pepassaco/CloCh/plots/preliminary_results_exp1.pdf

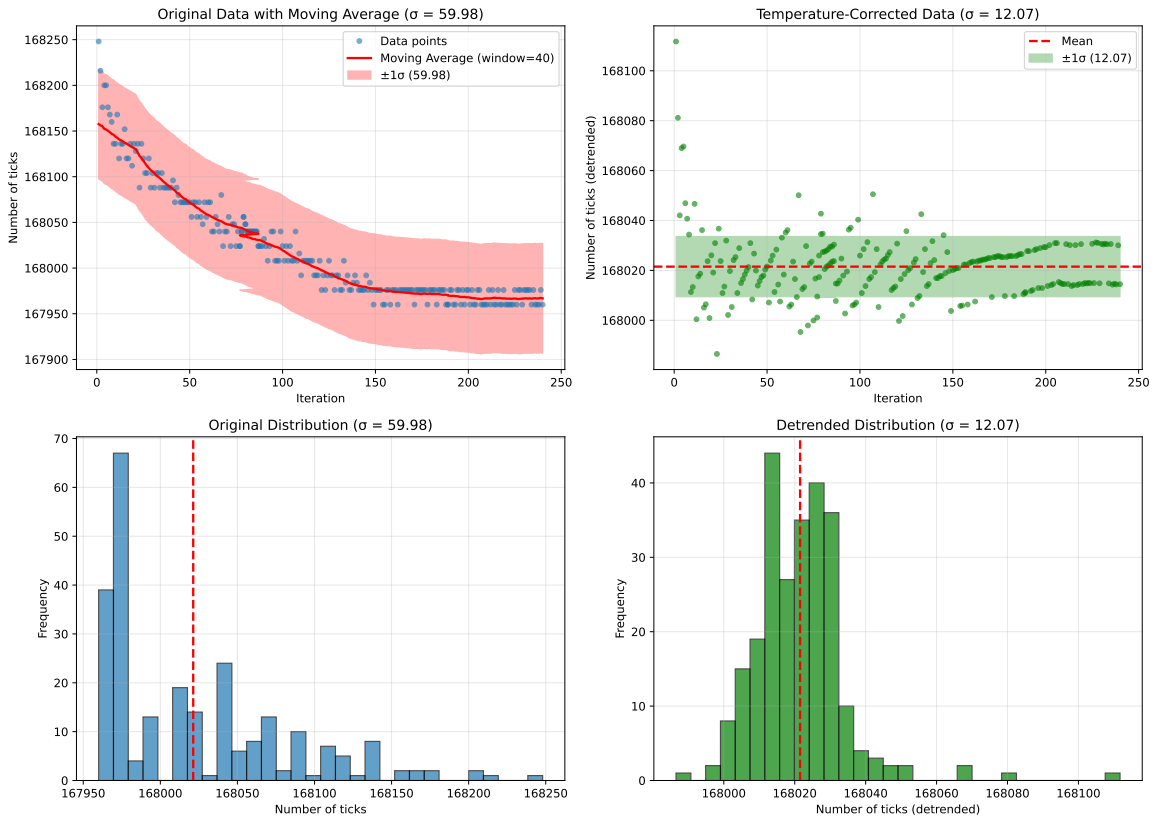
[picture p1: page 1]
Iteration; Mean; Frequency; Original Distribution ( = 59.98); Detrended Distribution ( = 12.07)

Original Data with Moving Average ( = 59.98)

Temperature-Corrected Data ( = 12.07)

Data points
Moving Average (window=40)

Number of ticks (detrended)

Number of ticks
