pepassaco/CloCh/plots/preliminary_results_exp2.pdf

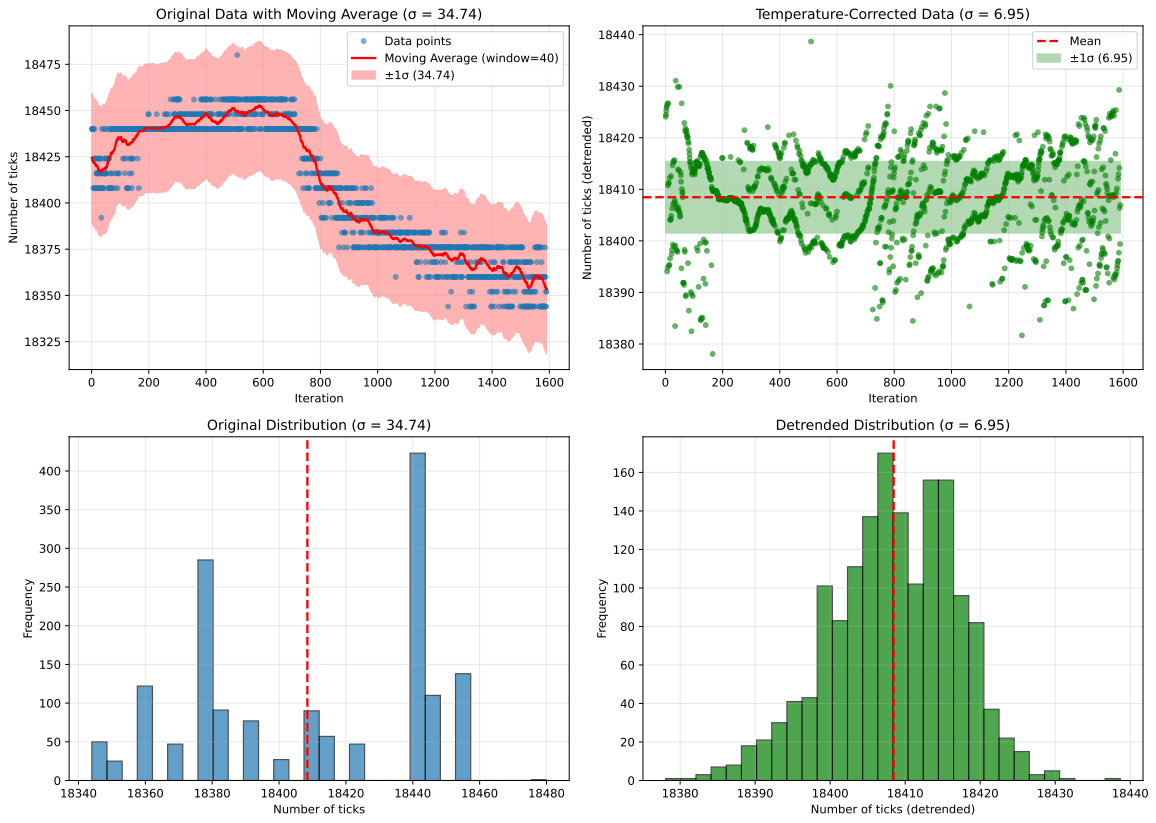
[picture p2: page 1]
Iteration; Mean; Frequency; Original Distribution ( = 34.74); Detrended Distribution ( = 6.95)

Original Data with Moving Average ( = 34.74)

Temperature-Corrected Data ( = 6.95)

Data points Moving Average (window=40)

Number of ticks (detrended)

Number of ticks
