pepassaco/CloCh/hardware/schematics/CloCh_v1.3_sch.pdf

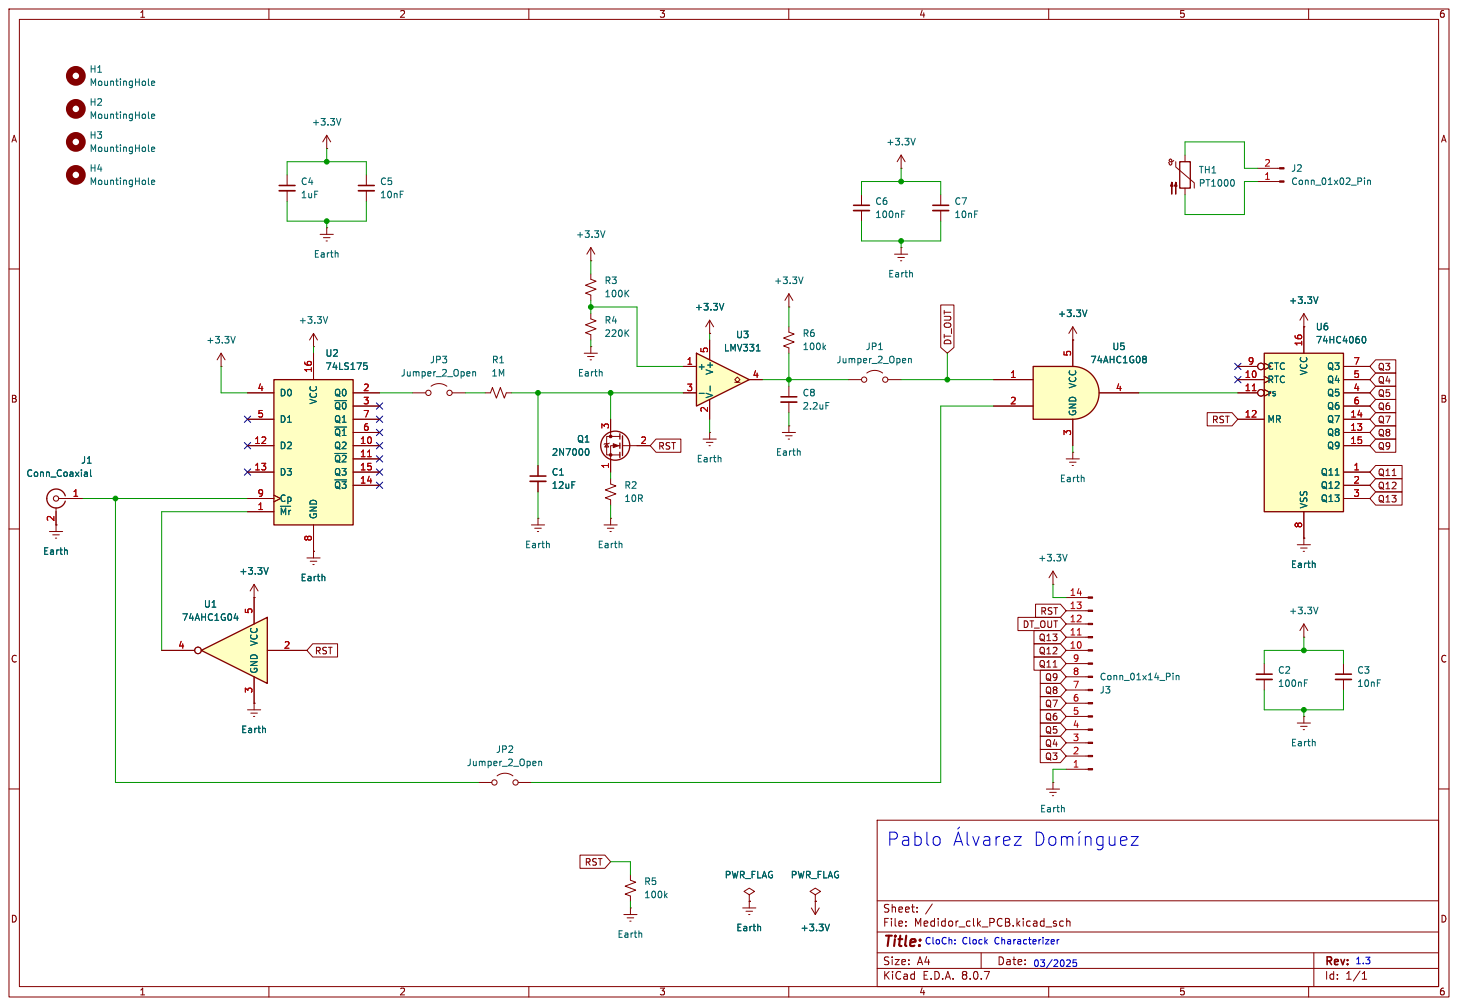
[picture p3: page 1]

Id: 1/1 Title: File: Medidor_clk_PCB.kicad_sch Sheet: / JP2

1.3 03/2025 CloCh: Clock Characterizer Pablo þÿÁlvarez þÿDomínguez
