pepassaco/CloCh/plots/paper_results_exp2.pdf

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

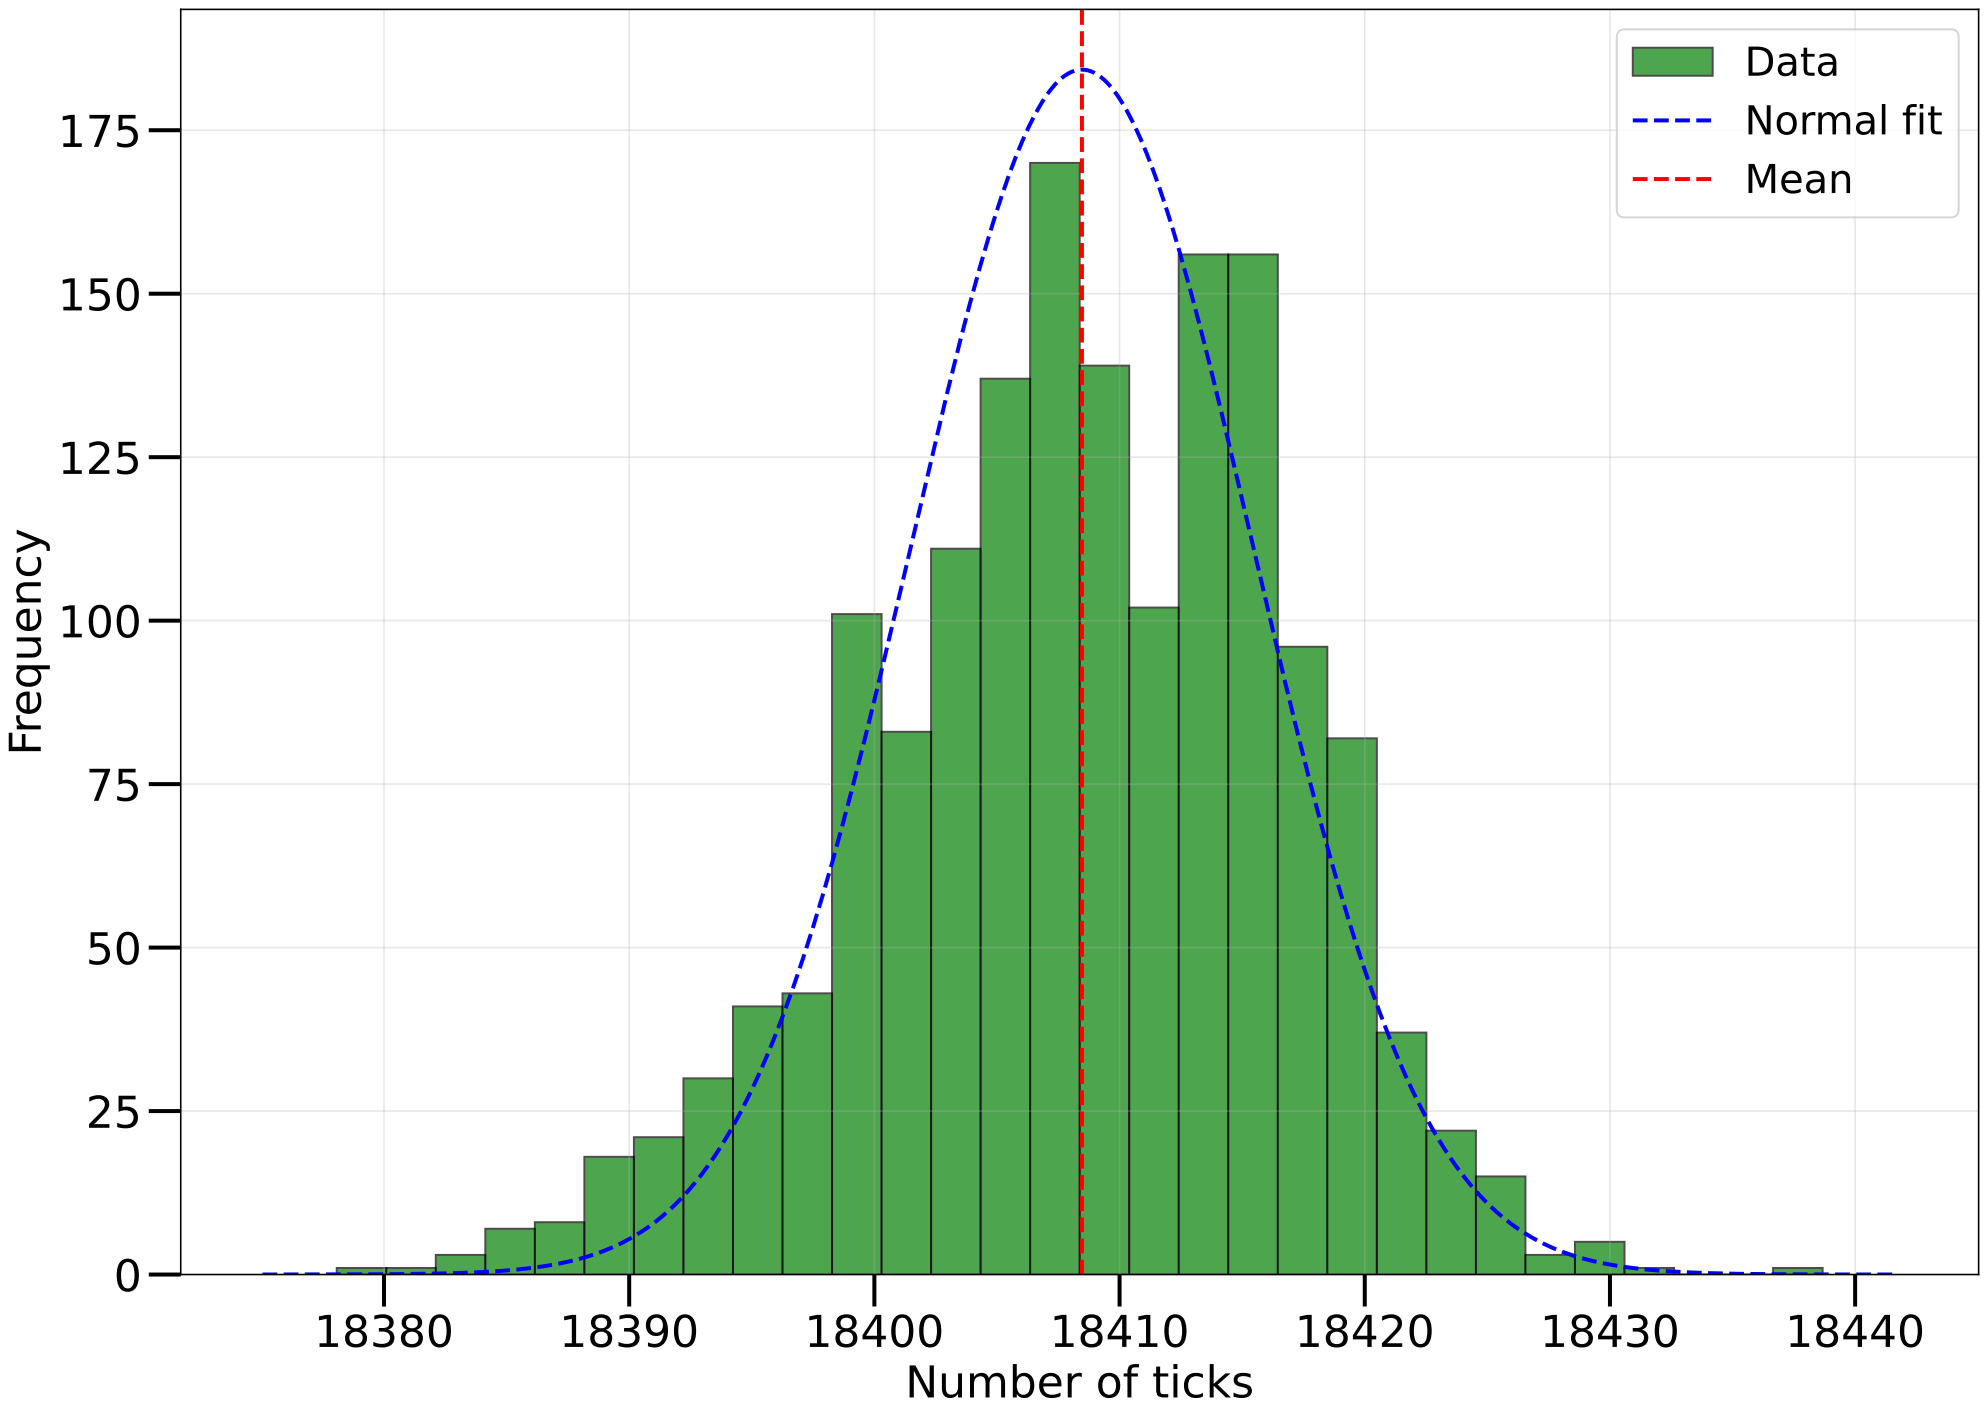
[picture p5: page 1]
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
