pepassaco/CloCh/hardware/schematics/CloCh_v1.3_pcb.pdf

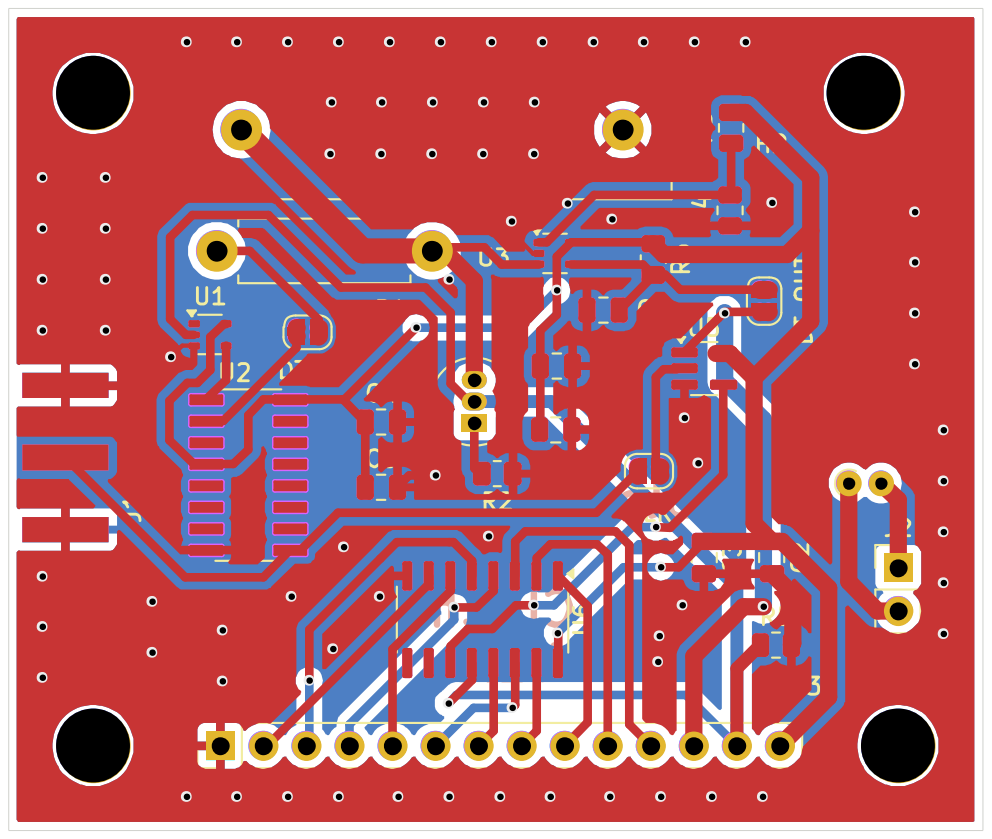
[picture p6: page 1]
