pepassaco/CloCh/hardware/PCB/kicad/CloCh_v1.3.kicad_pcb

## KiCad design hardware/PCB/kicad/CloCh_v1.3.kicad_pcb (2025-10-25)

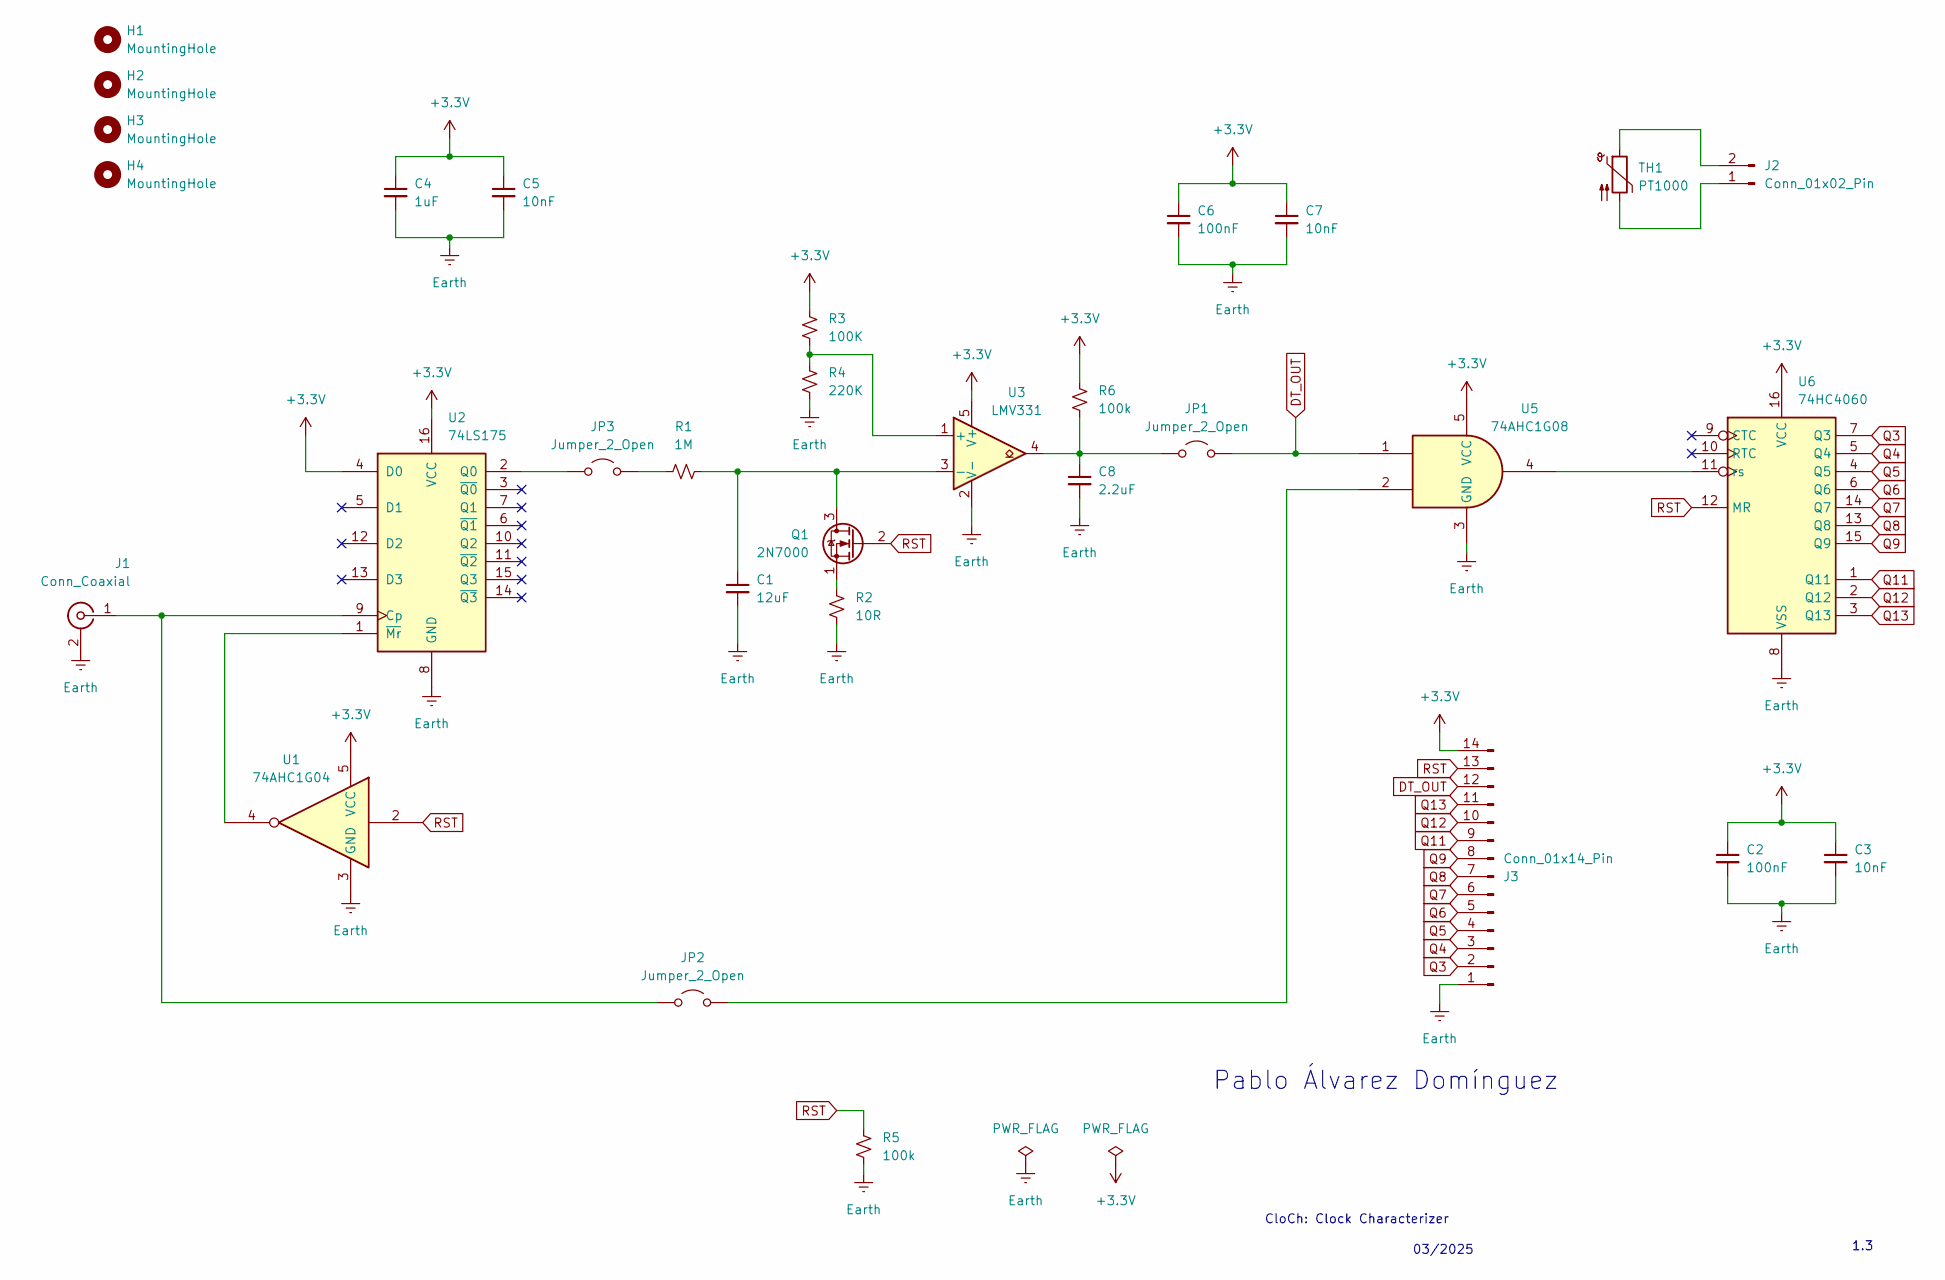
[picture p7: schematic CloCh_v1.3.kicad_sch]

Parts:
C1: 12uF; C_Rect_L28.0mm_W8.0mm_P22.50mm_MKS4
C2, C6: 100nF; C_0805_2012Metric
C3, C5, C7: 10nF; C_0805_2012Metric
C4: 1uF; C_0805_2012Metric
C8: 2.2uF; C_0805_2012Metric
H1, H2, H3, H4: MountingHole; MountingHole_4.3mm_M4_ISO7380
J1: Conn_Coaxial; SMA_Amphenol_132289_EdgeMount
J2: Conn_01x02_Pin; PinHeader_1x02_P2.54mm_Vertical
J3: Conn_01x14_Pin; PinHeader_1x14_P2.54mm_Vertical
JP1, JP2, JP3: Jumper_2_Open; SolderJumper-2_P1.3mm_Open_RoundedPad1.0x1.5mm
Q1: 2N7000; TO-92_Inline
R1: 1M; R_Axial_DIN0411_L9.9mm_D3.6mm_P12.70mm_Horizontal
R2: 10R; R_0805_2012Metric
R3: 100K; R_0805_2012Metric
R4: 220K; R_0805_2012Metric
R5, R6: 100k; R_0805_2012Metric
TH1: PT1000; R_Axial_DIN0204_L3.6mm_D1.6mm_P1.90mm_Vertical
U1: 74AHC1G04; SOT-353_SC-70-5
U2: 74LS175; SOIC127P600X175-16N
U3: LMV331; SOT-353_SC-70-5
U5: 74AHC1G08; SC-74A-5_1.55x2.9mm_P0.95mm
U6: 74HC4060; SO-16_3.9x9.9mm_P1.27mm

Connections:
+3.3V: C2.1, C3.1, C4.1, C5.1, C6.1, C7.1, J3.14, R3.2, R6.1, U1.5 (VCC), U2.4 (D0), U2.16 (VCC), U3.5 (V+), U5.5 (VCC), U6.16 (VCC)
DT_OUT: J3.12, JP1.2 (B), U5.1
Earth: C1.2, C2.2, C3.2, C4.2, C5.2, C6.2, C7.2, C8.2, J1.2 (Ext), J3.1, R2.1, R4.1, R5.2, U1.3 (GND), U2.8 (GND), U3.2 (V-), U5.3 (GND), U6.8 (VSS)
unnamed: J1.1 (In), JP2.1 (A), U2.9 (Cp)
unnamed: J2.1, TH1.2
unnamed: J2.2, TH1.1
unnamed: C8.1, JP1.1 (A), R6.2, U3.4
unnamed: JP2.2 (B), U5.2
unnamed: JP3.1 (A), U2.2 (Q0)
unnamed: JP3.2 (B), R1.1
unnamed: C1.1, Q1.3 (D), R1.2, U3.3 (-)
unnamed: Q1.1 (S), R2.2
unnamed: U1.4, U2.1 (~Mr)
unnamed: R3.1, R4.2, U3.1 (+)
unnamed: U5.4, U6.11 (rs)
Q3: J3.2, U6.7 (Q3)
Q4: J3.3, U6.5 (Q4)
Q5: J3.4, U6.4 (Q5)
Q6: J3.5, U6.6 (Q6)
Q7: J3.6, U6.14 (Q7)
Q8: J3.7, U6.13 (Q8)
Q9: J3.8, U6.15 (Q9)
Q11: J3.9, U6.1 (Q11)
Q12: J3.10, U6.2 (Q12)
Q13: J3.11, U6.3 (Q13)
RST: J3.13, Q1.2 (G), R5.1, U1.2, U6.12 (MR)

Notes on the sheet:
03/2025
CloCh: Clock Characterizer
1.3
Pablo Álvarez Domínguez

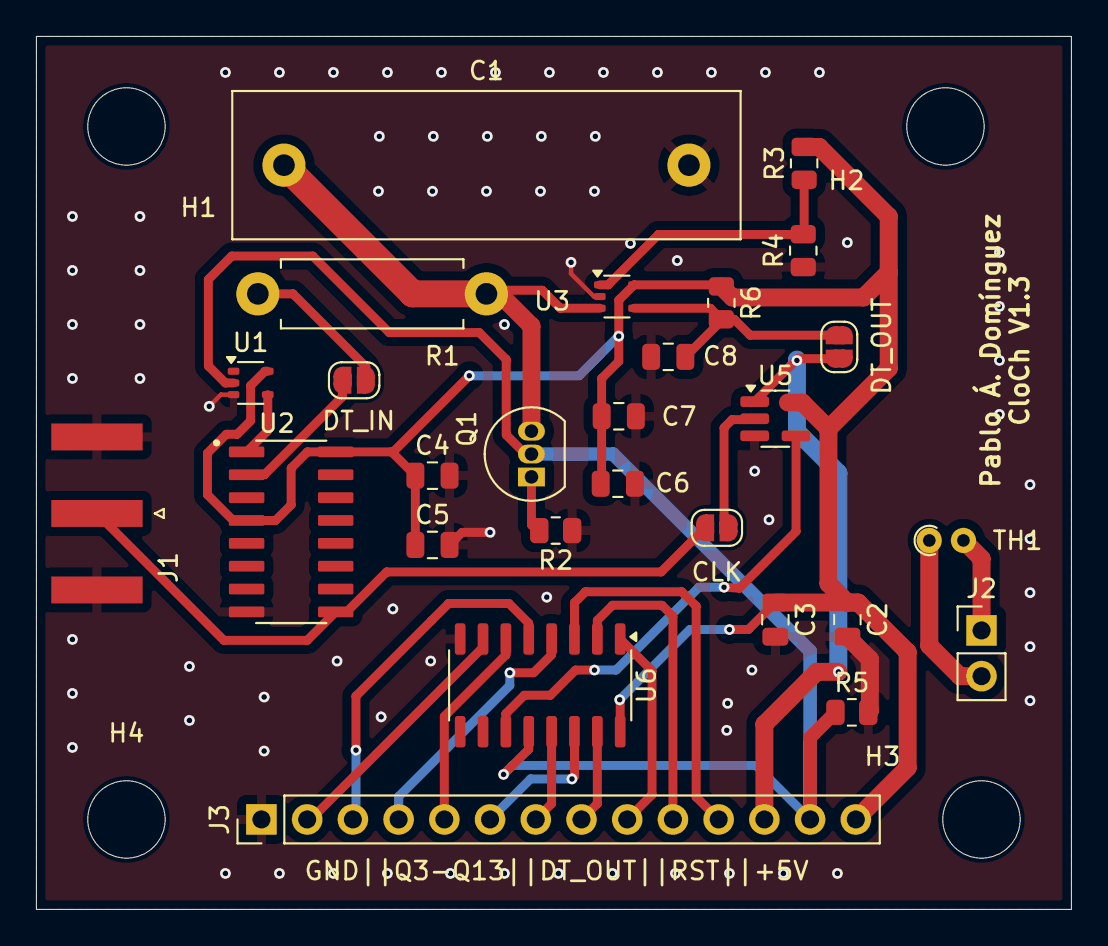
[picture p8: board CloCh_v1.3.kicad_pcb from above]

Board: 2 copper layers, 57.5 x 48.5 mm, 31 parts (0 on the bottom side), 26 nets.
