pepassaco/CloCh/(commit log)

2025-10-24 Initial commit with firmware and data
    [exp1.csv]
2025-10-24 Added PCB documentation
    [CloCh_v1.3-CuBottom.gbr, CloCh_v1.3-CuTop.gbr, CloCh_v1.3-EdgeCuts.gbr, CloCh_v1.3-MaskBottom.gbr, CloCh_v1.3-MaskTop.gbr, CloCh_v1.3-NPTH.drl, CloCh_v1.3-PTH.drl, CloCh_v1.3-PasteBottom.gbr]
2025-10-25 New plotter, adapted experiment for longer runs
    [exp2.csv]
2025-10-28 Modified temperature correction
2025-10-31 Added plotter for the paper and changed temperature correction
    [plotter.py, plotter_paper.py]
